voroshkov/Chorus-RF-Laptimer/docs/rx5808-spi-mod.md

#rx5805 SPI modification
In order to get the rx5808 to use SPI you will need to open it and remove a single SMD resistor.
(got this from [sheaivey/rx5808-pro-diversity](https://github.com/sheaivey/rx5808-pro-diversity) repository)
rx5805 SPI modification
