voroshkov/Chorus-RF-Laptimer/docs/pcbs.md

# PCB designs

## By Andrey Voroshkov:
PCB by Andrey Voroshkov

## By Joao Reis:
PCB by Joao Reis
