voroshkov/Chorus-RF-Laptimer/docs/img/ArduinoIDE_Menu_SerialMonitor.png

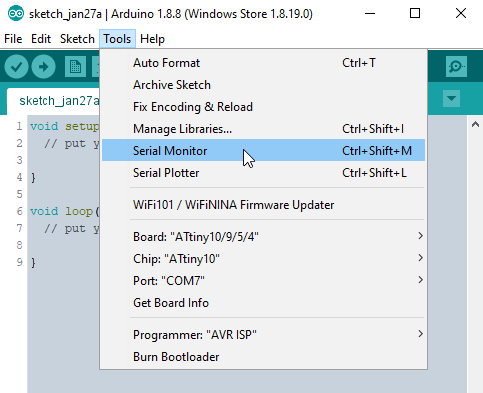
docs/img/ArduinoIDE_Menu_SerialMonitor.png
