voroshkov/Chorus-RF-Laptimer/docs/img/3DR_modules_setup.png

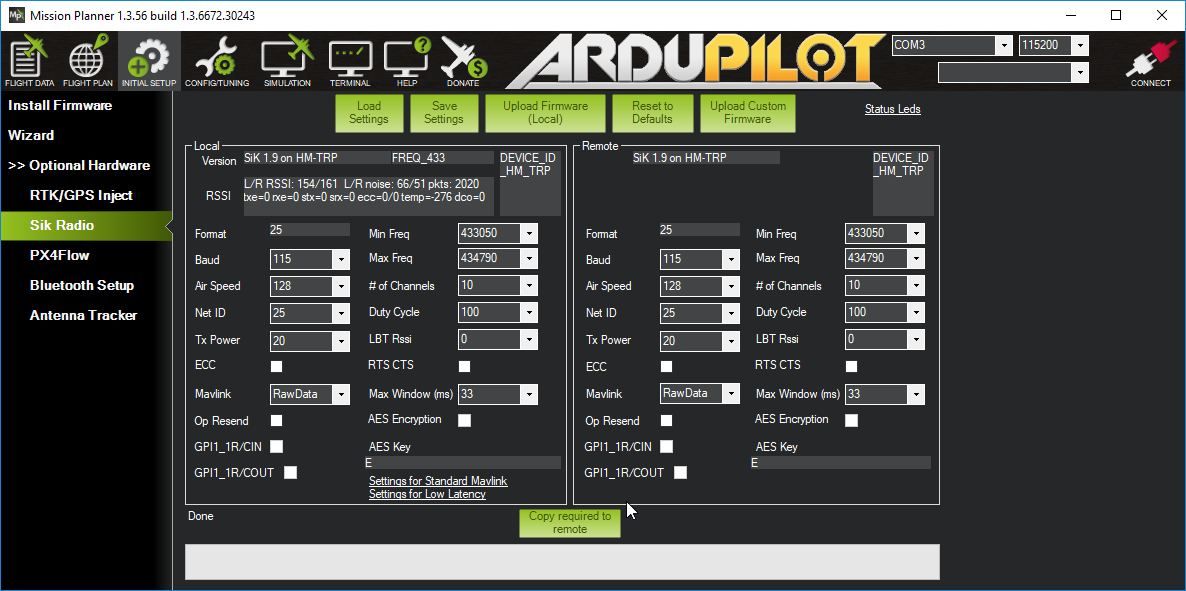
docs/img/3DR_modules_setup.png
