voroshkov/Chorus-RF-Laptimer/docs/img/HC06SetupArduinoSerial.png

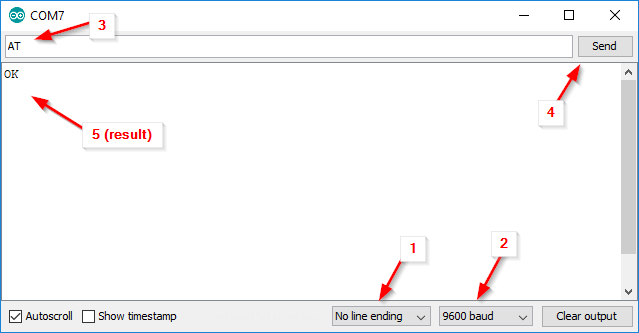
docs/img/HC06SetupArduinoSerial.png
