voroshkov/Chorus-RF-Laptimer/(threads)

Thread 3 (2017-03-14):

[Feature Request] Freq management

TJohn7002, 2017-03-14:
Hi Andrew,

I've got several ideas regarding frequencies management in Android app:

1. Display Freq, not only Channel and Band
2. Add ability to auto choose Using Freq from app\on device start-up (to make it more independent from android app):
2.1. Plug in battery in drone
2.2 Turn on Chorus device (or press it's button) (at ~1-2 m distance)
2.3 Chorus should scan all available bands and choose the one with strongest RSSI (~). Play sound when ready, go into Timer mode, play sound again
3. Save last used settings in App\or (and) Chorus device (Pilot name and Freq)

P.s. Timer mode is just like Race mode, but without limitations of lap number - just to save the timings

voroshkov, 2017-03-14:
Completely agree with 1 and 3.
What concerns 2 - it seems useful for a single racer, but looks inconvenient when you prepare a competition of several drones.

TJohn7002, 2017-03-14:
I was thought about this.
But there's workaround I've found:
1) In case if you you have single-RX device - I completely agree with you, there can be issue. Needed "Next" button as it done in  rx5808-pro Autoscan feature
2) In case if you have multi-RX device (able to measure >1 freq at the same time), then auto-scan can work step-by-step:
1) Search first strong Freq, assign it to first RX module
2) Continue search for next bands, and assign it to next modules.

But I agree -there could be collisions of bands because some chinese Tx are transmitting at several channels at the same time =(

voroshkov, 2017-03-14:
That makes sense. From UI standpoint it can be as simple as adding a button on a "Freq" tab, like "Autoscan", which will automatically scan known bands and assign different signal peaks to different devices!
So you'll just have to turn on all drones and click "Autoscan" to have bands/channels assigned.

TJohn7002, 2017-03-14:
Yep, that's I was thinking about)
Let's device itself do it's work)
Moreover I think it is possible to make Chorus device standalone:
add OLED screen and 3 buttons to make it independent from android app... This will increase cost of project by ~4$ but make it completely different from other devices that are already in the market.

voroshkov, 2017-03-14:
Well, the latter is questionable :)
Adding OLED will require separate controller for it (one more Arduino) and won'be convenient for organizing competitions, which was the primary target for Chorus.

TJohn7002, 2017-03-14:
Ok, just  ignore it than)

Thread 4 (2017-03-14):

[Feature Request] Android app > Use speech API to say last\best times

TJohn7002, 2017-03-14:
I think it will be great to hear last lap time once app got it from Chorus device.
Also it will be useful to hear best lap time right after last lap time.
smth like "Last lap: 23.6 sec... Best lap: 18.2 sec"
For the new best lap it will be just like "New Best lap: 15.8 sec"

highway11, 2017-03-14:
I agree this is a great idea. It  is a very beneficial feature to hear your lap times called out as you are flying with the goggles on!

Another open source lap timer I built does this. It runs in the web browser though, and I much prefer the Android app interface you have built for this one.

voroshkov, 2017-03-26:
https://github.com/voroshkov/Chorus-RF-Laptimer/pull/10

Closed 2017-03-26.

Thread 5 (2017-03-15):

Application doesn't seem to read BT data after reconnecting

voroshkov, 2017-03-15:
1. Power on Chorus device.
2. Connect from mobile app -> settings and current RSSI measurements are shown in the app
3. Disconnect
4. Reconnect again -> RSSI values are not being updated.
(not always reproducible)

FranzAr, 2017-03-15:
I can confirm this behaviour. If you kill the app completely and then restart it, it works again.

KingModest, 2017-03-17:
So there are actually two cases, when this bug appears:
1) launch app -> if connects -> exit with back button -> launch app -> connect -> (bug - not connecting properly)
2) launch app -> if connects -> disconnect -> connect -> (bug - not connecting properly)

The only way - is to kill the process of the app and connect

voroshkov, 2017-03-17:
Can you specify the symptoms of "not connecting properly?"

voroshkov, 2017-03-17:
As discussed: The app stops interaction with Bluetooth (doesn't transmit/receive data).
in the 1st case described by @KingModest FREQ and PILOTS tabs are empty.
in the 2nd case - UI remains, but buttons don't work (no data transmission occurs)
(Observed in Android 7.1.1)

Closed 2017-03-18.

Thread 7 (2017-03-16):

[Feature request] Low voltage Alarm

voroshkov, 2017-03-16:
It would be nice to have a low voltage alarm in the application if Chorus device is powered from accumulator.

traced, 2017-03-20:
Dont know if that would be useful, mostly it will be powered by a 5v stepdown. You would need another voltage divider "in front" to get the voltage in front of the stepdown.

voroshkov, 2017-03-20:
Right. That's not a priority, but nice to have.

Closed 2017-04-11.

Thread 8 (2017-03-17):

App doesn't update RSSI values after Chorus device was reset

voroshkov, 2017-03-17:
1. Power on Chorus device.
2. Run Android app and connect
3. Disconnect
4. turn off Chorus device, then turn back on.
5. Reconnect Android app
Result: RSSI readings not updated, whereas other features are working (swich channels, etc).

Closed 2017-03-18.

Thread 9 (2017-03-18):

Client application for different platforms.

Rikbruggink, 2017-03-18:
Hi!,

Would it be possible to create apps for different platforms like IOS or a as standard webapp for different embedded platforms like the Rasberry PI?

voroshkov, 2017-03-18:
Unfortunately I don't plan to learn iOS development in the nearest future. I'd be happy to assist if any iOS developer would join the initiative and create the app.

Rikbruggink, 2017-03-18:
Would it be possible to share the serial commands specification?

voroshkov, 2017-03-18:
It's already available in wiki: https://github.com/voroshkov/Chorus-RF-Laptimer/wiki

traced, 2017-03-20:
Just read about iPhones and the cheap HC-05 and HC-06 bluetooth modules. They don´t work with iPhones.

Rikbruggink, 2017-03-21:
Found the same info that the HC-* series are not compatibel with the Iphone, HM-10 is and around the same cost. @voroshkov thank you for the wiki link. I don't have the time currently to create an iphone app, sorry for that. Will follow the repository for updates.

nickspiel, 2017-06-14:
I am going to give a web app a crack. Just waiting on the parts to arrive. Should have something in a couple of weeks.

ps915, 2017-06-15:
awesome. looking forward to this

timofpv, 2017-10-10:
I could help with an WiFi webserver / homepage based soloution with an ESP8266. Would work with every device with an Browser and WiFi - laptop smartphone even with an ebook reader

voroshkov, 2017-10-10:
Hey, that's what I'm going to try in the nearest future. Would you contact me in facebook messenger to share/coordinate?

voroshkov, 2017-10-19:
App for iOS is in beta testing stage! You can join testing as described here: https://github.com/voroshkov/Chorus-RF-Laptimer/blob/master/README.md#hot-news-

nikybiasion, 2018-01-28:
Any news about a web app?

voroshkov, 2018-01-28:
nope. sorry. out of my priorities for now

Zai, 2019-04-21:
We are actually working on an integration of chorus to our web app : RotorMatch.com :)

voroshkov, 2019-04-22:
@Zai, let me know if you need any assistance regarding Chorus API or have any integration questions

Zai, 2019-04-22:
@voroshkov thx ! Actually I'm learning your API to see how I can wrap it to work with ours. ;)
I come back soon with a first integration to test. :)

Thread 11 (2017-03-22):

Store Channel, Pilot Name, and RSSI settings of each device between sessions

highway11, 2017-03-22:
A nice feature would be if the system could remember the last used settings for each device:

1. Channel/Band selection
2. Pilot name
3. RSSI Threshold. (this one may be debatable, as this might be better to set every time?)

Also (but less important) store these preferences: Enable Sounds, Enable Speech, Laps To Go, Min Lap Time

For example, at our weekly meetups, we always use the same 5 channels, (IMD5) and often even the same Pilots so it would be nice to be able to turn on the Chorus and the app automatically sets them all to the last used settings. This would make setup time very fast.

traced, 2017-03-22:
I think these values could be easily stored into the eprom?!

Closed 2017-04-11.

Thread 12 (2017-03-23):

RSSI not shown on last device

FranzAr, 2017-03-23:
Have 4 devices, on the Pilots tab the last device RSSI shows "1". If I do "Set" it works correctly. Laps are also triggered correctly.

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

voroshkov, 2017-03-23:
Did you update the Android app and Arduino firmware since last weekend?
Is the issue persistent? Does it work this way right after connection and after disconnect/connect cycle?

FranzAr, 2017-03-23:
Yes, both latest version

voroshkov, 2017-03-23:
Do you have the problem with 4 devices only? Can you describe the use case?

FranzAr, 2017-03-23:
Yes, had no problems like that with only 2 devices. Was just testing on the bench, but I could reproduce this behaviour every time. Gonna do some more investigation, when I have the time. On the Freq Tab it shows the right value, it's only on the Pilots tab. Just a small issue but wanted to let you know.

voroshkov, 2017-03-23:
Got it. Thanks. Will take a look.

voroshkov, 2017-03-24:
I guess I've found the reason of the described issue.
@FranzAr, can you try the updated APK from attached archive and let me know if it fixes the problem?

[ChorusRFLaptimer-release.zip](https://github.com/voroshkov/Chorus-RF-Laptimer/files/867188/ChorusRFLaptimer-release.zip)

FranzAr, 2017-03-24:
Great, I'll try it tonight

FranzAr, 2017-03-24:
Yes, problem seems to be solved, I get plausible values now on all 4 devices.

voroshkov, 2017-03-24:
Cool. Will include the fix into next release then.

Closed 2017-03-25.

Thread 17 (2017-04-13):

Idea: Alternative connection through FTDI/UART

Szpero, 2017-04-13:
Reason: BT and 2.4GHz are often jammed by frsky and other stuff. 433MHz for example will handle without a problem with much more longer distances.

Idea: Connect FTDI converter through OTG cable.
To FTDI you can connect any device like:
- straight cable to arduino
- 433MHz (or other) modems on frequencies which are not in use by race quads.

Application: need to be changed.

Arduino side: no need - just any other device than BT module.

Hardware: For example FTDI based on CH340G (tested with library) and pair of transmiting devices which can handle 115kbps on air.

Proposed library: https://github.com/mik3y/usb-serial-for-android

I'm not so expeirenced with java but for now only FTDI library is merged.

traced, 2017-04-13:
Can 433Mhz modules handle the baud rate?

Szpero, 2017-04-14:
Many 433MHz data links for pixhawk/apm telemetry are able to use 250kbps air speed to maintain 115kbps inner connection for device.
Here is example of device which is working at different frequency but its able to work at 250kbps also:
http://www.banggood.com/3DR-Radio-Telemetry-915MHZ-Module-For-APM-APM2-p-73539.html

From what I've seent most of those devices are using:
- USB with build in FTDI converter
- transmiting modules which can be configured with AT commands.

Within end of month I'm going to replace BT module (config link) on my Pixhawk flyer. It is good oportunity to check link device for other purposes :)

tigert, 2017-04-15:
Would it work with a ESP2866? Those are arduino compatible, so you could run the whole thing in one, and setup a wifi hotspot on your phone.

You could even log the results in a mqtt server or talk to the app over wifi.

traced, 2017-04-15:
ESP8266 works with 3.3v, so you would need something to provide two voltages (3,3v for ESP and i think 5v for the RX module).

tigert, 2017-04-15:
If you have one of those modules with usb, like the nodemcu amica or adafruit huzzah, there is the usb/5V pin if you power it via usb. I do that to power a DHT11 temperature sensor that also needs 5V and it works.

tigert, 2017-04-15:
Or maybe some logic level converter might work.

Closed 2017-07-01.

Thread 19 (2017-05-01):

Android apk build

mclei, 2017-05-01:
I am not Android developer, so maybe stupid question, but I am not able to compile the application with this error:

FAILURE: Build failed with an exception.

* What went wrong:
A problem occurred configuring project ':app'.
> Could not resolve all dependencies for configuration ':app:_debugApk'.
   > Project :app declares a dependency from configuration 'compile' to configuration 'default' which is not declared in the descriptor for project :bluetoothspp.

Please could you help me?

voroshkov, 2017-05-01:
I use latest Android Studio for compiling. It should work without issues.

mclei, 2017-05-01:
I am also using latest Android Studio on Debian/Squeeze. Both Studio and "gradlew assemble" throws this error.

voroshkov, 2017-05-02:
Well, to be honest, I'm not an Android developer either. Hope somebody more experienced could help here.

gpolic, 2017-05-02:
That is a long shot, but are you sure you are using "Import Project."?
Usually when trying to open a project directly there are various problems. Import project, is taking care of the dependencies.

Also try to update Gradle and see if it makes a difference.

I am on windows and the latest Android Studio and I cannot recreate this error message.

mclei, 2017-05-02:
I am also not Android developer. I am using "Import Project". Have gradle 3.5 and Android Studio 2.3.1.
Why I want to compile the project is that there is explicitly forced English for Text to Speech and I want to use the system settings.

gpolic, 2017-05-03:
I am not Android Developer either, but I am trying to learn.

Looks like the Text to Speech code is hard coded for U.S. settings
I dont know how to change that but will have a look

voroshkov, 2017-05-03:
Yes, it's all hardcoded so far. In order to Internationalize we'll need to make localization for the entire app. (all texts, user-defined spoken messages, etc.)

voroshkov, 2017-05-03:
Btw, the code becomes more and more ugly with adding new features (due to flaws in initial design and lack of Android development experience). Need to perform thorough refactoring before implementing anything significant.

mclei-asw, 2017-05-03:
But your project is COOL and we are already using it in the field :-) Thanks.

mclei, 2017-05-03:
But your project is COOL and we are already using it in the field :-) Thanks.

gpolic, 2017-05-04:
Inside TextSpeaker.java in the onInit method
You can use this to obtain the default locale, and pass it to setLanguage instead of "Locale.US"

@TargetApi(Build.VERSION_CODES.N)
public Locale getCurrentLocale(){
    if (Build.VERSION.SDK_INT >= Build.VERSION_CODES.N){
        return getResources().getConfiguration().getLocales().get(0);
    } else{
        //noinspection deprecation
        return getResources().getConfiguration().locale;
    }
}

I found this info here:
http://stackoverflow.com/questions/14389349/android-get-current-locale-not-default

Also this is very useful:
http://stackoverflow.com/questions/38189386/texttospeech-setlanguage-not-working

mclei, 2017-05-04:
Yes, I have ideas how to change it, but I am not able to compile the project and this task is about it :-)

gpolic, 2017-05-04:
I would do the change in a PR, but I am unable to test :-(
maybe @voroshkov can compile that for you and include it in the project

As for the refactoring. Yes it maybe needed specially if new functionality is being added. You could start by doing adding more test units, to assist in more efficient refactoring.

voroshkov, 2017-05-04:
As for including this into the project:
Guys, I don't think using system locale is enough for the app to work properly. All messages should also be localized and auto-selected upon choosing a locale.
Also this may result in not speaking pilot names (if they don't correspond to system locale): e.g. I tried using my name in Russian, but Speech Engine with US locale just doesn't pronounce it.

gpolic, 2017-05-04:
oops! yeap you're right. Translation is needed.

lnx13, 2017-06-19:
`Project :app declares a dependency from configuration 'compile' to configuration 'default' which is not declared in the descriptor for project :bluetoothspp.`
This error occured becose you use case sensitive file system, just rename bluetoothSPP to bluetoothspp

mclei, 2017-06-19:
Confirmed, never noticed it is that simple :-)

Closed 2017-06-19.

Thread 20 (2017-05-06):

Help with Arduino Nano

androidiano78, 2017-05-06:
Hi,
I just finished assembling a Solo device, but with Arduino Nano (not having Arduino Pro Mini). For now I have missed the part for voltage Lipo monitoring. That said, everything connects to the application via the bluetooth module, but I did not understand, the FREQ android app page, what is that number next to Device # 1, in my case 234. Going to the PILOTS page, RSSI Threshold gives me Always 1, and until I insert the above mentioned number (234), but it does not give me the option to set it, START RACE (1PILOT) does not appear on the RACE page. Once START RACE starts and I try to make a ride with the quadcopter (walking naturally for now, both with powered and non armed motors, but I do not think it makes any difference) when I step in front of the device nothing happens and does not ring buzzer. I would need help to figure out what the problem is, especially with wiring, since I am using Arduino Nano, but it should be compatible. I have only one device, so I did not connect the 4 pins to series more devices; In addition I did not even have the bridge to shorten two pins of Bluetooth (loopback jumper in scheme), I seemed to understand that it was to do for multiple connected devices.

My PinOut and configuration:

I supply everything from lipo - bec USB to mini USB - Arduino nano;
Ch1-Ch2-Ch3 (RX5808) - 1k resistors - D12-D11-D10 (Arduino nano);
GND (RX5808) - GND (HC-06 Module) - one of the 2 GNDs (Arduino nano);
+ 5v (RX5808) - 5V (Arduino nano) - VCC (HC-06 Module);
RSSI (RX5808) - A6 (Arduino nano);
Positive (Buzzer) - D6 (Arduino nano);
GND (Buzzer) - one of the 2 GNDs (Arduino nano);
RX0 (Arduino nano) - TXD (HC-06 Module);
TX1 (Arduino nano) - RXD (HC-06 Module).

I attach some photos and thank you in advance.
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

voroshkov, 2017-05-06:
Why do you connect RSSI to A6?

androidiano78, 2017-05-07:
Oh my god, I apologize for the lapse and for the time that I made you lose .... I put the pinout, which among other things I was wrong also the CH, and now magically everything works. Now I have to test it only in flight. Congratulations on the work done

voroshkov, 2017-05-07:
Good to have it solved! :)

Closed 2017-05-07.

Thread 22 (2017-05-27):

Built with 5 SOLO issue

vannoz, 2017-05-27:
Hello, I built a Chorus version with 5 SOLO. I have an issue when selecting players: name of 5th and 1st are the same and 5th SET rssi value doesn't change from 0, rtx receive the signal, but button SET doesn t work..only strange bip...any idea?
(Wirimg is ok, Uno pro are all ok...)
thanks

voroshkov, 2017-05-30:
Can you make sure you use the latest app? Does it have LiPo monitor adjustment feature?
If yes, then please specify what Android device you are using.

voroshkov, 2017-05-31:
Is Freq tab entirely visible on the screen or the 5th item is off?

vannoz, 2017-06-01:
Hello Andrey, here you can see a video from my mobile:
https://youtu.be/iBP88XJ0LvI
Thanks
Ciao
Andrea

Il 31/mag/2017 16:29, "Andrey Voroshkov" <notifications@github.com> ha
scritto:

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

voroshkov, 2017-06-01:
Thanks for the vid. I'll try to investigate what's happening. Looks like incorrect handling of  lists in android app. I'd appreciate if experienced Android devs could join and help here.

vannoz, 2017-06-01:
Yes...unfortunately i'm olny Android user :)
maybe depends on the software you have used to build the Android app...I
tried the MIT App Inventor...but is not easy

Il 01/giu/2017 10:53, "Andrey Voroshkov" <notifications@github.com> ha
scritto:

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

maddust, 2017-06-21:
I'm having the same problem . Any update with this issue?

vannoz, 2017-06-21:
I think nothing up to now...Andrey is working to solve

Il 21/giu/2017 21:31, "maddust" <notifications@github.com> ha scritto:

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

voroshkov, 2017-06-22:
Does anybody experience the same issue having different number of nodes? 4, or 6?

vannoz, 2017-06-22:
With 4 units no problems...i don't have a 6th unit to do the test sorry

Il 22/giu/2017 08:40, "Andrey Voroshkov" <notifications@github.com> ha
scritto:

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

vannoz, 2017-07-04:
ciao Andrey, I have some suggestios.
I tested this Sunday the laptimer chorus RF...mine is 5 unit...but if you
remember only 5 are working on the android app...
I used with 4 racers per time...we selected only 4 VTX frequencies...and
all the time I was changing the pilot name...then loosing a lot of time
My request is> is it possible to add a page where to list all players name,
then when preparing the partecipants to a race, select the names of the
participants from a drop down menu?
it will be also a good things to assign a COLOR code to some frequency...
it will be also a good things to see the MHz freq value per each
channel/band...because some time the VTX on the quad has not the same table
MHz vs channel/band...

thanks
ciao
Andrea

voroshkov, 2017-07-04:
@vannoz valid points, but out of scope of this bug. Would you create a feature request(s) instead?

highway11, 2017-07-04:
I'm also experiencing this bug. I recently added 2 more modules to upgrade from a 4 unit to 6 unit device. In the Pilots tab any changes I make to the 6th module get mirrored to the first one. I also cannot disable the 6th module to continue with 5 as the checkbox does not seem to work on the 6th as well

vannoz, 2017-07-04:
Thanks. So I just have to install the new version?

Il 04/lug/2017 22:17, "Andrey Voroshkov" <notifications@github.com> ha
scritto:

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

vannoz, 2017-12-14:
have you seen this?
https://www.banggood.com/LANTIAN-5_8G-Wide-Voltage-Bluetooth-Timer-Personal-Practice-Version-for-FPV-Racing-Drone-p-1237993.html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

voroshkov, 2017-12-14:
Yep. Already discussed in FB group :)

vannoz, 2017-12-14:
Ah ok...sorry :)

Il 14/dic/2017 12:46, "Andrey Voroshkov" <notifications@github.com> ha
scritto:

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

voroshkov, 2017-12-14:
Oh, you really shouldn't be! Thanks for notifying anyway!

vannoz, 2017-12-14:
You did a great job...so I was scared seen others gain money with your idea!

Il 14/dic/2017 12:50, "Andrey Voroshkov" <notifications@github.com> ha
scritto:

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

voroshkov, 2017-12-14:
If I could make huge money of it I'd try to :) So far I'm happy as it gains popularity as long as the license permits :)

Closed 2017-07-04.

Thread 23 (2017-05-31):

Only one Pro Mini

mario123456789o, 2017-05-31:
Hi,
wouldn't it be possible to use one Arduino only. Wire all the spi pins as in the rx5808 diversity, but use different pins for the chip Select pins. So if you have for rx5808, wire chipselect 1 to d1, cs 2 to d2 ...
So you would use only one arduino, the stackability is a bit worse, because you have to limit it to number of rx5808, but to be honest who needs more than 8 different modules?
If my rx5808s ever arrive, I will test this.
Greetings
Mario

voroshkov, 2017-06-01:
Theoretically it's possible, but out of scope of this project, sorry.

mario123456789o, 2017-06-01:
Ok
I'll try my idea as soon as my rx5808s arrive, and if it works I'll notify you :).
The limitation is that we only have 8 analog pins available(at least for my arduino :D) so a maximum of 7 rx5808s can be used. But this should be enough for most people otherwise you have to sacrify the battery pin.
The other problem might be the performance, that the arduino is too slow to read 7 analog inputs in realtime

Closed 2017-07-01.

Thread 25 (2017-06-06):

Bluethooth Range

ps915, 2017-06-06:
Hey Guys,

Whats your Bluethooth Range? HC05 has a pretty bad range so here is an idea.

To keep the Tracker Compact, we might use a class 1 bluethooth module. That will get us 100+ meters range: https://www.sparkfun.com/products/12580

The bad thing is, that most smartphones dont support class 1 except the iPhone 7 i think.

So, maybe its possible to write an Chrome App, or standalone App for a Laptop and use this Class 1 Bluethooth Adapter.

https://www.sparkfun.com/products/9434

A friend also tested various wifi modules like ESP... he only got 10 meters and had TCP/IP packages losts

...or..

is there any "Android App" Emulator which accepts bluethooth connectivity?

ps915, 2017-06-06:
I have an other idea for increasing the range dramatically without loosing the bluethooth feature.
Lets build a master slave class 1 bluethooth gateway. Should work:
https://cdn.sparkfun.com/datasheets/Wireless/Bluetooth/bluetooth_cr_UG-v1.0r.pdf

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

highway11, 2017-06-06:
I find it makes a big difference if you can elevate the bluetooth module above the ground. I use CAT5 cable to extend mine out and away from the Chorus box.  I can get around 50m away from it and still have communication that way. Its elevated maybe 1.5 meters off the ground.

ps915, 2017-06-06:
Thanks for your contribution. 50m with Cat5 is awesome. i should try that. If it works stable, the above solution is overkill, indeed! =)

highway11, 2017-06-06:
My CAT5 cable is only about 4 meters long. Then I just mount it on a stick to elevate it :) Very low tech solution, but it works for me!

ps915, 2017-06-25:
I just bought this as a range enxtender =)

Chorus -> UART RF  .>.>.><.<.<. UART RF -> HC05/Laptop (Gui from Daniel Müller )

https://www.aliexpress.com/item/2x-UART-RF-Wireless-Transceiver-Module-USB-to-TTL-RS232-Telemetry-Kit-2-4G-for-Arduino/32239562366.html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

FranzAr, 2017-06-25:
Phil, does ist work like expected?

ps915, 2017-06-25:
I'll report back asap I'll hold it in my hands. ;)

FranzAr, 2017-06-25:
Ah, thought you got it already. I'll be waiting ;-)

rcdesigns, 2017-07-15:
I hang my timer from a tree branch and easily reach 20m to where we sit. I'm sure it would go further.

rcdesigns, 2017-07-15:
I presume soldering on a better antenna would improve things a lot

Thread 28 (2017-06-25):

8in1 PCB Version 2

ps915, 2017-06-25:
OK guys,

a while ago, i created a 8in1 PCB for the Chorus Tracker. It was my first design and of course the PCB was not 100% correct. There were some GND Pins of the Arduino not connected together "GND Island Fail".

Now i came up with the Idea to create a stackable design.

So there will be a 10x10 PCB with all the RX5808 receiver on top. You can either direct solder them or stackable with Pin Headers.

A second PCB, the Main PCB will be connected also with pin headers.

I will create a second Main PCB for the Delta 5 Tracker as well. So one can choose if he wants to build delta5 or chorus.... or even another tracker.

All Arduinos from the PCB before can be used for this PCB as well. 2 pin headers were added becaus i included a buzzer which is shared with all 8 nodes via some schottky diodes.

There is also an option to mount two XT30 connectors to the PCB and also a stepdown (Pololu 5V, 2.5A Step-Down D24V25F5) to power the whole unit via a LiPo. Second option is to power the unit via a external 5V source (powerbank)

Why two XT30? If the battery will run out of power, just connect a fresh one and charge the old one.

An other feature is the Rj45 jack where you can plug in a network cable to extend the range of your bluethooth.

What is your opinion? Whats missing?

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

Rikbruggink, 2017-06-26:
It looks really great Phillip!. Are you gonna release the pcb's to seedstudio or osh?

ps915, 2017-06-26:
sure, they will be released on Seeedstudio when the testing is done and everything is fine

ps915, 2017-07-10:
Update: Just decided to go with 8in1 PCB, no stackable RX PCB :-P

Ok guys. I spend a few weeks designing Chorus 8in1 V2 which should be the final version.
Features:
- 10x10 PCB
- up 8 Nodes (if you use 6 nodes, just bridge TX/RX)
- 1 shared buzzer for all nodes (protected by diodes)
- 2x XT60 Input
- 2x MicroUSB 6V Input (Adafruit MicroUSB Breakout Board)
- 1x Serial Output RJ45 Socket
- 2x Serial Output Pin-Header
- 5V Stepdown ready (MP1584EN)
- all parts stackable (parts can be replaced easily, also better airflow, less heat)

As always, i will test it before publishing, but i think i wont find any issues this time =)
After that, you can order it yourself on seeedstudio.com
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

cbnlnk121, 2017-09-04:
@ps915 Maybe I'm missing it, but what's up with the dual XT60? I assume is runs right to the 5V stepdown first? Sorry for the newb question, just having a hard seeing the trace.

cbnlnk121, 2017-09-05:
Deleted my prior comment ... Re-reviewing the trace, it's dual inputs. Great idea! Thanks!

Chewpasta, 2017-12-03:
hi, i have a cuestion in this project, do you have a pcb with only 4 nodes?  ty!

ps915, 2018-02-16:
I wont release the 8in1. Instead i nearly finished the 4in1. Stay tuned!

Closed 2018-02-16.

Thread 29 (2017-06-26):

Feature Request: WS2812 LEDs

ps915, 2017-06-26:
Why not hooking up a WS2812 LED Stripe to the first node?

1. Pilot Colors
Every Pilot gets a color and the start gate will shine in the pilots color when passing it.

2. Visual Countdown
add a bright ws2812 led panel in front of the starting pads or even the whole start gate.
So there is a visual start sign. When the race is finished or the pilot has max laps, the gate will show red.

What do you think?

Code: https://github.com/adafruit/Adafruit_NeoPixel

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

FrufoFPV, 2017-06-26:
I really like the idea. Its pretty much the same as TBS has implemented for their Racetracker and SmartGates.

Ziege-One, 2017-06-26:
Nice
 I would build it as a new module like the others.
All information comes over the serial line.
So you pick them up

AABatteries, 2017-06-28:
I would recommend using the FastLED library as opposed to NeoPixel one - it's more versatile, and offers better performance than the latter.

It would be a great addition, I might make a pull request once I have it working (but no earlier than a month time). I think adding a connector (just 3 pins) to make it possible to plug in a cable to both power (from the same LiPo) and send signal to the LEDs, so that the tracker can be placed away from the gate, would be the easiest/best way to physically implement this.

Repo for FastLED can be found here: [FastLED library on GitHub](https://github.com/FastLED/FastLED)

reptil1990, 2017-07-10:
I started coding! Could need some help: https://github.com/reptil1990/Chorus-RF-Laptimer

voroshkov, 2017-07-12:
Idea for possible implementation of this feature: instead of loading the Solo module with new features you may like to create a separate Arduino module which will just proxy all commands as other modules do, but implement only its specific functionality (drive LEDs in our case). So the chain of modules might look like:
Solo <-> Solo <-> ... Solo <-> LED module <-> Bluetooth.
This way the LED module will "see" all commands/responses from other modules and may be also programmed using a separate command set.

voroshkov, 2017-10-09:
Implemented in Chorus-LED-Module project.
https://github.com/voroshkov/Chorus-LED-Module

Closed 2017-10-09.

Thread 40 (2017-07-09):

[request] - Manual RSSI input

jRreis, 2017-07-09:
Request for manual RSSI input in Text format in android APP.

RSSI can only be Set/Clear and Increased or decreased by the value of 1, every time +/- is pressed.

It would be a plus to allow RSSI values to be directly inserted, as text format, for manually set the value.
E.g.. if we want to set manually an RSSI of 243, "+" must be pressed until that values is reached.  In text, we would be able to directly input the value "243".

FranzAr, 2017-07-09:
+1
Great idea, maybe RSSI value could be stored, as you don't really have to change it a lot for different quads.

rcdesigns, 2017-07-15:
Yes, just storing the last RSSI value would be great.  I find I'm always using around 200 and don't need to calibrate every time.

kestux75, 2017-08-22:
+1 for storing the last RSSI

voroshkov, 2018-04-27:
done in release 0.6.1: https://github.com/voroshkov/Chorus-RF-Laptimer/tree/0.6.1

Closed 2018-04-27.

Thread 43 (2017-07-12):

Feature request : allow communication with LapTimer modules using OTG USB device (3DR telemetry receiver, FTDI, ...)

sky022, 2017-07-12:
Hi,

This is the first issue I write on GitHub... :)
I made several laptimer modules since a few days, and it works like a charm. I'm using Bluetooth to UART modules as recommended, but the range is not so great.

I was thinking : in fact, the whole thing is based on serial communication. To extend the range of operation, we could use something else instead of Bluetooth, that would be connected as an OTG USB device on the smartphone.

For instance, I was thinking about using a 3DR radio telemetry combo like this one : https://www.banggood.com/3DR-Radio-Telemetry-433MHZ-Module-For-APM-APM2-Europe-p-85233.html?rmmds=search

Unfortunately, for the moment the LapTimer app only connects to Bluetooth devices. Do you think you could implement something to improve the application, so that any other supported serial communication device connected via OTG USB can be used ? I'm thinking about EZ-GUI app also, which supports this kind of thing.

Thank you for reading :)

BR,
Fabien (sky022)

allsiolek, 2018-05-05:
I'm using 3dr telemetry radio right now and i just found this post. It's working, you have to setup radio properly. I'm recomending to use mavlink protocol, low netID, air speed > 128.
First radio is connected to last node, second to bluetooth / wifi module. Sometimes i have to connect two times (connect -> disconnect-> concect) with Chorus to proper readings.

voroshkov, 2018-05-07:
@allsiolek, Thanks for the info!
What's the longest range you were able to achieve with 3dr?
How do you connect it to wifi/bt module? As I can see, one of the modules comes with the USB converter to connect to PC directly. (https://www.banggood.com/3DR-Radio-Telemetry-433MHZ-Module-For-APM-APM2-Europe-p-85233.html)

allsiolek, 2018-05-12:
I didn't try further than 100m thru the buildings with stock antenna. I used this two telemetry radio:
https://www.banggood.com/500mW-3DR-Radio-Telemetry-AirGround-Module-433MHz-915-MHz-For-MWC-APM-PIXHAWK-Pirate-p-982005.html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

https://www.banggood.com/3DR-500mW-915MHz433MHz-Radio-Telemetry-Module-w-OTG-for-Android-Phone-p-1140481.html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

With first one i have stable connection. Second thing is that radio from second link hae a bug. For correct work you have to cut trace (https://diydrones.com/forum/topics/3dr-telemetry-always-bootloader).

First telmetry radio is connected to Chorus Laptimer thru RS232 TTL, second one is connected also thru Rs232 to  wifi DT06 module. I also tried with bluetooth module (HC-06) but bluetooth+telemetry radio works worse.

I did try use HC-12 433MHz modem but it didn't work. I think beacuse this modem dosen't suport full duplex transmision.

If you will able to add usb connection option it will be simple but now is still fine.
I will test for you range of stable link in open air.

voroshkov, 2018-05-14:
@allsiolek  Thanks a lot for the detailed description!

Thread 54 (2017-09-12):

I can't connect with Windows GUI

MoonKIE666, 2017-09-12:
Hello everyone,

I can not connect to the Windows application.

I connect my CHORUS 5 in 1 through a FTDI to my pc, I open the windows GUI and I get the startup window, but I only get the baud rate dropdown, I put it in 11520 and the COM port dropdown does not appear .

What's going on? My FTDI works correctly, I installed the firmware on all my mini arduino with it. And in the Windows Device Manager I appears as connected on the COM3 port.

Let's see if someone can help me.

I've also tried connecting it to GOOGLE CHROME's EASYRACELAPTIMER app, but it will not let me.

anunique, 2017-09-22:
you might want to post problems like that @ https://github.com/anunique/ChorusGUI

guess this one can be marked as solved since its not a problem with the chorus-rf-laptimer project at all ;]

Closed 2017-09-25.

Thread 56 (2017-10-01):

Different Modes for the Android app

ty8447, 2017-10-01:
Hello, I have been using the Android app a lot and love it, but I was wondering if there was a modded version of the app that includes a point mode where there is a countdown timer and during that set time, people race to get the most amount of laps. When the time is over people can finish their lap and then they are done. This is similar to how normal multigp races are scored.

highway11, 2017-10-02:
I've added this feature to my branch. It's fairly crudely implemented but you can do a timed race for 1.5, 2, or 2.5 minutes. It announces time remaining at certain intervals as well as when the time is up

ty8447, 2017-10-04:
@highway11 How would I set that up? Would I have to upload new code to the pro mini and/or download a modded version of the Android app?

highway11, 2017-10-04:
You would just need the app. There is no code I have changed for the Arduinos

Closed 2017-10-06.

Thread 59 (2017-10-05):

Cannot get the RF rx5808 module to work

ty8447, 2017-10-05:
I recently ordered 4 rx5808 modules from Banggood and when they finally arrived and I removed the metal casing, the resistor that you explain how to remove is not installed from the beginning. I solder the wires following the diagram and cannot get the app to let me calibrate/change the frequency or pilot. What does the "Lipo Voltage" go into (Red lead on the diagram), and how might I go about fixing this issue?

voroshkov, 2017-10-05:
1. Please follow the guide in the Troubleshooting section to resolve the app issue.
2. The LiPo Voltage wire should go to + of the lipo you're using to power the Chorus

ty8447, 2017-10-05:
Thank You @voroshkov, My Bluetooth baud rate wasn't set.

Closed 2017-10-05.

Thread 60 (2017-10-05):

Cannot Calibrate Timers in Chorus App

ty8447, 2017-10-05:
Now that the lap timer will connect, I have all of the functionality except in the race tab, the calibrate timers button does not show when the app connects with the device. Also, where is the button to set the current threshold?

ty8447, 2017-10-05:
I did a check with the components and found out that one of my pro mini boards was dead :( but everything now works.

Closed 2017-10-05.

Thread 61 (2017-10-06):

RSSI values drop to zero when race starts

ty8447, 2017-10-06:
I do not if this is meant to happen, but when the race starts the values go to zero. Are there any more descriptive details on how to setup the RSSI values to racing?

voroshkov, 2017-10-06:
That's ok. When you start the race, the device stops transmitting current RSSI data.
This is to minimize the BT communication with the device and keep it more reliable & accurate.

Closed 2017-10-06.

Thread 62 (2017-10-06):

Ability to Manually Type RSSI Threshold

ty8447, 2017-10-06:
Can there be an added feature in the near future to click on the RSSI value and type in a number, rather than only being able to press the buttons?

anunique, 2017-10-07:
check https://github.com/voroshkov/Chorus-RF-Laptimer/issues/40

the arduino code supports setting the rssi threshold, somebody just needs to add it to the android app ;]

voroshkov, 2017-10-07:
sorry guys, I won't add.
long button clicks changes by 30.
10 long clicks is enough to cover all range

Closed 2017-10-08.

Thread 63 (2017-10-07):

First Pilot/Device only reads 1018 for the RSSI level no matter what

ty8447, 2017-10-07:
I have two lap timers and when they connect with the phone, the lap timer with the Stepdown (Timer 1/ Pilot 1) does not give an accurate RSSI level. The second lap timer on the other hand, does work in the app and pc version. All of the wiring is the exact same on both devices and in the diagram, and I have tried everything in the troubleshooting section.

voroshkov, 2017-10-07:
please describe the sympthoms

ty8447, 2017-10-08:
When I open the app and have two Solo's connected, the second solo will give an accurate reading of the rssi value and the first solo that has the 5v step down displays 1018 for it's value regardless of Band/Channel. When you start the race, as you mentioned in another issue that they will go to zero to help with communication and that happens for both (so the software is controlling that).

voroshkov, 2017-10-08:
Maybe you have bad (or not patched) vrx.
Try measuring actual voltage on its RSSI pin - it should be around 0.5 - 1.5 V

ty8447, 2017-10-10:
If I use a multimeter to measure the rssi pin on the rx5808 using the positive lead for the rssi and ground being anywhere else (preferably the 5v step down) I get a reading of about 5v.

voroshkov, 2017-10-10:
that's wrong RSSI. probably your RX5808 is damaged

Closed 2017-10-23.

Thread 64 (2017-10-09):

Trigger on peak RSSI

kestux75, 2017-10-09:
Trigger lap time on peak RSSI. With only rssi > rssiThreshold, precision is very sensitive to vtx/antenna power and  rssiThreshold value.

voroshkov, 2017-10-09:
Please clarify. Is there an issue? Or it's a suggestion? What's the idea?

kestux75, 2017-10-09:
It's not a big issue,  but I think it would be a an improvement. Sometimes then two or more quadcopters passes finish line at the same time, I have not correct order registered. I think it's because now lap time is triggered as soon as rssi > rssiThreshold. But it's not exactly the closest point to the gate and its very sensitive to rssiThreshold setting. The closest point would be when rssi is at the max value.
My suggestion is after rssi > rssiThreshold to wait for rssi peak to register lap time.

Sorry for my english.

voroshkov, 2017-10-10:
Got it. The idea is really nice. Need to think and experiment.

elvince, 2017-10-13:
In fact, you can take some inspiration from https://github.com/scottgchin/delta5_race_timer
His program is better suit to get the best lap time because it sample different value one the threshold is reached and wait until the rssi value is lower. Then it "save the highestepeak time as the lap time. This will greatly improve your code.

BTW, thanks a lot for sharing to the community, this is a great stuff.

voroshkov, 2017-10-13:
Thanks for pointing out. I'll take a look.
At the same time I heard rumors that Chorus worked better than Delta5 in certain conditions ;)

elvince, 2017-10-13:
Might be, it would be great to know what were those conditions.
The simple implementation is to read multiple value between Threshold  reached / unreached and keep the highest rssi peak for the laptime.
Then we can see if there are "false positive" during this period and check delta value after/before the peak and use that to compare to the 2nd "best value". If gap are big, the 2nd value might be the best one. What's important to improve the system is to know in real testing, if we have wave rssi peak. I mean, you start getting bigger value, then drop a bit then up again then drop.. up ... and got under the threshold. If this is the case, the simple implementation won't work and we need to create a more robust approach.
 I have no clue how it will react in reality, it is just coding approach.
I need to create my timer first ^^

voroshkov, 2017-10-13:
True. It would be great if someone had enough courage and time to make the research and suggest a good algorithm :)
On the other hand I strongly believe that the "right" construction of the laptimer box might also be the clue to more sharp readings. E.g. narrowing down the "RF sensitivity window" (whatever it might be) will eliminate the necessity of improving the software.

anunique, 2017-10-14:
well this could be possible if the first gate pass == tracker pass.
i woulnt use the way delta5 uses since they so somethink like:
((time of rssi trigger value edge up)+(time of rssi trigger value edge down)) / 2
if the tracker is placed directly infront of the first gate you could simply increase the value till its falling down a special rssi value ?

fape, 2017-10-26:
By me you can get some inspiration from [Chickadee laptimer58](https://www.rcgroups.com/forums/showthread.php?2558061-Chickadee-Tech-DIY-Laptimer) too.

Thread 65 (2017-10-12):

Possibility to change VOLTAGE_DIVIDER_CONSTANT in app instead of hardcoded

Maarten112, 2017-10-12:
Hi Voroshkov,

Let me start by saying: THANK YOU SO MUCH for this great project and making it opensource.

I noticed that in the hardware schematics you use a voltage divider with 10K and 1K, however, I found this a bad choice for a 3S lipo that I will use since the resolution is really low with this kind of voltage divider and the use of a 3S Lipo:

Full 3S lipo: 12.6V --> 1.145V out of the voltage divider
Empty 3S lipo: 9.9V --> 0.9V out of the voltage divider

The resolution with this divider is 0.245 volt (+/- 50 digital resolution)

I choose to use a voltage divider with 10K and 22K, since it gives much better resolution:

Full 3S lipo: 12.6V --> 3.938V out of the voltage divider
Empty 3S lipo: 9.9V --> 3.094V out of the voltage divider

The resolution with this divider is 0.844V (+/- 172 digital resolution)

In the app (AppState.java) on line 43 you hardcoded the voltage divider constant that is used for the final battery voltage calculation:

public static final double VOLTAGE_DIVIDER_CONSTANT = 11; //(10K + 1K)/1K

It would be great to not hard code this, but make it editable in a configuration menu (or maybe advanced configuration menu?).

voroshkov, 2017-10-16:
Is your choice of resistors suitable for lipos from 2s to 6s?
On one hand the feature of Lipo monitoring is supplementary, and doesn't require high resolution.
On the other hand, using higher resistances leak less current and provide better monitoring capabilities.

On one hand I'd avoid changes to schematic as many people already developed their devices.
On the other hand it might be solved by allowing to configure it via UI, as you suggest.
At the same time I'd really avoid adding too much configuration options to UI.

Kind of difficult decision :)

Maarten112, 2017-10-16:
Hi voroshkov,

No this voltage divider is only suitable for up to 3S (and gives the best resolution on 3S). A full 4S lipo would already give 5.25V out on the analog pin and probably destroy the arduino.

I agree with you that the android app should be as clean and simple as possible, there is no point in making it over complicated. I understand your concerns, however I think there is no real good argument to use a 6S lipo for the Chorus laptimer hardware, since we only need a maximum of 5V (or perhaps 12V for an external fan). It would only put more stress on the dc dc regulators to use 6S.

voroshkov, 2017-10-17:
@Maarten112, the device is quite energy-hungry, especially taking into account possible number of nodes, so this is the main reason to power it with batteries of high voltage and capacitance. I find it absolutely reasonable to power it with 6S or whatever else.
Sorry, but the feature you request is not to be implemented now.

chipko, 2017-10-17:
I have used a uBEC with 5.25v out without issue but this isn't advisable :D

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

Closed 2017-10-17.

Thread 66 (2017-10-13):

Improvment: Link up to 3 receiver per arduino

elvince, 2017-10-13:
Hi,

First thanks for sharing this, it is really great.

Why didn't you link more receiver per Arduino? I think you can put up to 3 per arduino.
Was it because the loop will take more than 1ms?

If not, it might be an improvment that allow to have cheaper kit for 3 drones (which is great for friend racing!)

Thanks!

voroshkov, 2017-10-13:
Because of modular design.
Suggested improvement is out of scope of this project.

Closed 2017-10-13.

Thread 68 (2017-10-24):

Feature Requeste - Smart RSSI Detecting

ps915, 2017-10-24:
I always hate to calibrate the RSSI values before the race when you are two groups.

Why not measure the RSSI of each quad when they passes the first time the start/-finish gate like its done by the Delta5 Tracker?

voroshkov, 2017-10-24:
Can't imagine any reliable algorithm of measuring RSSI on-the-fly without any additional tools.
E.g. if for the first time you fly high above the gate should it be chosen as valid RSSI threshold? Or if you fly too close to the laptimer? How would it track further passes if you then fly higher (with lower RSSI)?

Thread 69 (2017-10-26):

Documentations

CorentinPacaud, 2017-10-26:
https://github.com/voroshkov/Chorus-RF-Laptimer/blob/1e01318f48f0c909f864a3713422c2f551f02a34/Arduino/chorus-rf-laptimer/rx5808spi.h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

Hi,
this is not an issue but a question about documentation.
In the code quoted (5lines), why did you do that ?
How did you know you have to do this transformation of data ?

Thx

voroshkov, 2017-10-27:
1. This code was contributed by @anunique.
2. There's an algorithm in rx5808 datasheet.

Closed 2017-10-27.

Thread 70 (2017-10-30):

TIMED RACE OPTION for rc buggies

ivkostic, 2017-10-30:
Hi! Great features so far! We tried it on the rc track for buggies, and is working superb! Only needed option for time limit for counting the laps/best lap. Can it be added 5 10 15 20 and 30 min of race, for counting the laps? This can be very usefull for rc car training

ivkostic, 2017-10-30:
ops i just saw an other topic with the similar header, this should be posted there.

voroshkov, 2017-10-30:
Wow! Are you using 5.8GHz VTx's just for laps tracking?

ivkostic, 2017-10-30:
yes  and it is perfect! we have a tons of ideas for buggy racing

ivkostic, 2017-10-30:
https://www.youtube.com/watch?v=KWu0FfP6fwM

lazar89nis, 2017-10-30:
Hi Andrey,

I wanted to show them how cool is you Android app for quadcopter racing and they took my device and started racing cars with it  :)

I can implement that part in iOS app but they only have android devices that is why i sent them to you :D

voroshkov, 2017-11-01:
Guys, sorry, but so far I don't have plans to extend the functionality of the Android app in this direction. Feel free to contribute and extend it.

voroshkov, 2018-04-27:
duplicate of #21

Closed 2018-04-27.

Thread 74 (2017-11-26):

Error while compiling

FPV-Rover, 2017-11-26:
I have to use Arduino 1.0.5 because it`s the only version which is running without problems on my GalliumOS, while compiling i always get the following error message:

#################################################################################
/usr/share/arduino/hardware/tools/avr/bin/avr-g++ -c -g -Os -Wall -fno-exceptions -ffunction-sections -fdata-sections -mmcu=atmega328p -DF_CPU=8000000L -MMD -DUSB_VID=null -DUSB_PID=null -DARDUINO=105 -D__PROG_TYPES_COMPAT__ -I/usr/share/arduino/hardware/arduino/cores/arduino -I/usr/share/arduino/hardware/arduino/variants/standard /tmp/build7368876175063967868.tmp/chorus_rf_laptimer.cpp -o /tmp/build7368876175063967868.tmp/chorus_rf_laptimer.cpp.o
In file included from chorus_rf_laptimer.ino:225:0:
sendSerialHex.h: In function ‘uint8_t send4BitsToSerial(uint8_t, uint8_t)’:
sendSerialHex.h:80:16: error: ‘class HardwareSerial’ has no member named ‘availableForWrite’
     if (Serial.availableForWrite() >= 5) { // e.g. "S1R1\n"
                ^
sendSerialHex.h: In function ‘uint8_t sendByteToSerial(uint8_t, uint8_t)’:
sendSerialHex.h:93:16: error: ‘class HardwareSerial’ has no member named ‘availableForWrite’
     if (Serial.availableForWrite() >= 6) {
                ^
sendSerialHex.h: In function ‘uint8_t sendIntToSerial(uint8_t, uint16_t)’:
sendSerialHex.h:106:16: error: ‘class HardwareSerial’ has no member named ‘availableForWrite’
     if (Serial.availableForWrite() >= 8) {
                ^
sendSerialHex.h: In function ‘uint8_t sendLongToSerial(uint8_t, uint32_t)’:
sendSerialHex.h:119:16: error: ‘class HardwareSerial’ has no member named ‘availableForWrite’
     if (Serial.availableForWrite() >= 12) {
                ^
sendSerialHex.h: In function ‘uint8_t sendLaptimeToSerial(uint8_t, uint8_t, uint32_t)’:
sendSerialHex.h:132:16: error: ‘class HardwareSerial’ has no member named ‘availableForWrite’
     if (Serial.availableForWrite() >= 14) {
                ^
chorus_rf_laptimer.ino: In function ‘void readSerialDataChunk()’:
chorus_rf_laptimer.ino:731:67: error: invalid conversion from ‘uint8_t* {aka unsigned char*}’ to ‘char*’ [-fpermissive]
In file included from /usr/share/arduino/hardware/arduino/cores/arduino/HardwareSerial.h:28:0,
                 from /usr/share/arduino/hardware/arduino/cores/arduino/Arduino.h:193,
                 from chorus_rf_laptimer.ino:51:
/usr/share/arduino/hardware/arduino/cores/arduino/Stream.h:76:10: note: initializing argument 1 of ‘size_t Stream::readBytes(char*, size_t)’
   size_t readBytes( char *buffer, size_t length); // read chars from stream into buffer
          ^
chorus_rf_laptimer.ino: In function ‘void sendProxyDataChunk()’:
chorus_rf_laptimer.ino:788:36: error: ‘class HardwareSerial’ has no member named ‘availableForWrite’
##################################################################################
Can someone help me fixing that ? or is there a workaround ? I goggled a lot but didnt found a working fix for that.

Thanks
Moe

voroshkov, 2017-12-01:
Moe, it looks like the versions of libraries you are using are outdated and don't support functions used in the "chorus_rf_laptimer.ino". You have to use more recent version of libraries (not sure if they are tied to Arduino IDE version)

FPV-Rover, 2017-12-02:
Appreciate for that info :+1: Spend 2 Hours to get the Arduino 1.8.5 to run and now i can compile :-) tomorow i will assemble it.
If somebody has the same issue:

The Problem was a missing Java runtime. I got the following failure message:

Picked up JAVA_TOOL_OPTIONS:
java.lang.Error: Cannot load com.sun.java.swing.plaf.gtk.GTKLookAndFeel
	at javax.swing.UIManager.initializeDefaultLAF(UIManager.java:1351)
	at javax.swing.UIManager.initialize(UIManager.java:1459)
	at javax.swing.UIManager.maybeInitialize(UIManager.java:1426)
	at javax.swing.UIManager.getLookAndFeel(UIManager.java:492)
	at processing.app.linux.GTKLookAndFeelFixer.installGtkPopupBugWorkaround(GTKLookAndFeelFixer.java:79)
	at processing.app.linux.Platform.setLookAndFeel(Platform.java:41)
	at processing.app.Base.<init>(Base.java:224)
	at processing.app.Base.main(Base.java:144)

It was simply just the missing java rte... but the v8 and 7 doesn`t support the Arduino IDE... so the solution was to install the icedtea-next rte (sudo apt-get install icedtea-next)

Now it runs like a charm.

Cheers
Moe

Closed 2017-12-02.

Thread 76 (2017-12-06):

[Request] Penalty button

JLOFPV, 2017-12-06:
It would be interesting to add a penalty button, so that if a driver jumps a door, can press and discount a specific time of that lap. Also, this time was configurable by each user. I attach example images.
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

jelly013, 2018-06-15:
Also maybe a option to delete a lap. Sometimes when I miss a gate I have to re-align and sometimes it triggers the timer. So I had a lap of 3 seconds

Thread 80 (2018-01-20):

PCB 4in1

Tomkanovik, 2018-01-20:
Does enyone have PCB 4in1 with efficient use of space? Please send me link for it.

ps915, 2018-02-16:
Like this?
https://www.youtube.com/watch?v=avLRJ5z0UP4

I am working on it. Hopefully released soon. Actually found one little think i must change on the PCB, rest is working

ps915, 2018-02-16:
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

Tomkanovik, 2018-02-17:
yes like this it is very nice :)

targetdozer, 2018-03-26:
What is the Status of the 4 in one? I will build up a Chorus for our Team. PCBs are new to me, so I would like to get some ready to order.
One question to your Layouts (8in1 and 4in1): Why do you mont the Receivers with the covered side up?
voroshkov writes:
Assembly of a Solo device
Correct positioning of RX5808 module against the finish gate area is vital for correct measurements.
I tried using different types of antennas and shields with RX5808 to achieve the best possible accuracy, and finally found that the module itself works as a short-range directional antenna.
# The non-shielded side of the module is a surface that should face the gate, so consider this fact upon assembling.

ps915, 2018-06-10:
Here you go:
https://github.com/ps915/Chorus-RF-Laptimer-PCB

ALopes90, 2018-09-25:
@ps915 the @targetdozer question is a very valid one, the "The non-shielded side of the module is supposed to face the gate?" I saw many people building one way and other building the other way, can't anyone test using it? I already order everything to build a 4 in 1 and I will make a 3D printable box to use with it and share it, but depending the way it needs to face the box with be different. Thanks

voroshkov, 2018-09-25:
I used both sides (practical use on our local events, which last from morning till evening). Both work fine.
I guess there may be differences, but someone needs to invent a method of testing to check which is more accurate ;)

ALopes90, 2018-09-25:
Ok Thanks, Good work

Thread 85 (2018-04-27):

Android app: pilots' names repeat after connecting to Chorus

voroshkov, 2018-04-27:
Description from a post in the Facebook Chorus group by StevenStudio Corp:

I built a Chorus with 6 nodes but I have a problem with the name of pilots, that is systematic when I my mobile android disconnects and reconnects to the Chorus. The pilots names 4, 5 and 6 become the same as pilots 1, 2 and 3.
When I use 4 nodes it is the same driver name that is repeated on all the nodes.
I use the latest version of Chorus Laptimer for android on a Huawei Honor 6 phone and a module DT06 wifi

Thread 86 (2018-04-27):

Android app relies on keeping all fragments in memory

voroshkov, 2018-04-27:
The app uses a "hack" to prevent unloading its screens from memory upon running setOffscreenPageLimit(4) (https://github.com/voroshkov/Chorus-RF-Laptimer/blob/1e01318f48f0c909f864a3713422c2f551f02a34/Android/ChorusRFLaptimer/app/src/main/java/app/andrey_voroshkov/chorus_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)

But this in unlikely the common practice in Android development.
Removing this line crashes the app when switching between screens.
I guess this needs to be fixed (remove setOffscreenPageLimit, and prevent app from crashing)

Thread 89 (2018-05-27):

The Chorus RF Laptimer v 0.75 application crashes when trying to reenter it

ammarraisafti, 2018-05-27:
# Expected behavior
After opening the Connect via Bluetooth feature, then switch to landscape display mode. the ability to switch to landscape view mode should be possible. And once the user exits the app. the ability to enter into the application too should be possible.

# Actual behavior
After unlocking the Connect via Bluetooth feature, then switching to landscape display mode, I redirected to the main page of the app. Next I minimize the app, then log back into the app, suddenly the application crashes and stops.

# How to reproduce
1. Install and open the app.

2. Click the top right shortcut, then select and open the Connect via Bluetooth feature.

3. Next you have to switch to landscape display mode, then you will find the problem as I have experienced. *Redirected to app main page.*

4. Next you have to minimize the application, then log back into the application. Then you will find the problem as I have experienced. *The application suddenly crashes and stops.*

* Browser: Samsung Galaxy S6 edge
* Operating system: Nougat 7.0
* App version: 0.7.5

# Recording Of The Bug
https://youtu.be/NFWPiGtgMm0

# Logcat
 <code> --------- beginning of crash
05-23 19:23:01.939 13357 13357 E AndroidRuntime: FATAL EXCEPTION: main
05-23 19:23:01.939 13357 13357 E AndroidRuntime: Process: app.andrey_voroshkov.chorus_laptimer, PID: 13357
05-23 19:23:01.939 13357 13357 E AndroidRuntime: java.lang.NullPointerException: Attempt to invoke virtual method 'int app.akexorcist.bluetotohspp.library.b.a()' on a null object reference
05-23 19:23:01.939 13357 13357 E AndroidRuntime: 	at app.akexorcist.bluetotohspp.library.a.b(Unknown Source)
05-23 19:23:01.939 13357 13357 E AndroidRuntime: 	at app.andrey_voroshkov.chorus_laptimer.c.a(Unknown Source)
05-23 19:23:01.939 13357 13357 E AndroidRuntime: 	at app.andrey_voroshkov.chorus_laptimer.b.a(Unknown Source)
05-23 19:23:01.939 13357 13357 E AndroidRuntime: 	at app.andrey_voroshkov.chorus_laptimer.p$2.onClick(Unknown Source)
05-23 19:23:01.939 13357 13357 E AndroidRuntime: 	at android.view.View.performClick(View.java:6205)
05-23 19:23:01.939 13357 13357 E AndroidRuntime: 	at android.widget.TextView.performClick(TextView.java:11103)
05-23 19:23:01.939 13357 13357 E AndroidRuntime: 	at android.widget.CompoundButton.performClick(CompoundButton.java:130)
05-23 19:23:01.939 13357 13357 E AndroidRuntime: 	at android.view.View$PerformClick.run(View.java:23653)
05-23 19:23:01.939 13357 13357 E AndroidRuntime: 	at android.os.Handler.handleCallback(Handler.java:751)
05-23 19:23:01.939 13357 13357 E AndroidRuntime: 	at android.os.Handler.dispatchMessage(Handler.java:95)
05-23 19:23:01.939 13357 13357 E AndroidRuntime: 	at android.os.Looper.loop(Looper.java:154)
05-23 19:23:01.939 13357 13357 E AndroidRuntime: 	at android.app.ActivityThread.main(ActivityThread.java:6682)
05-23 19:23:01.939 13357 13357 E AndroidRuntime: 	at java.lang.reflect.Method.invoke(Native Method)
05-23 19:23:01.939 13357 13357 E AndroidRuntime: 	at com.android.internal.os.ZygoteInit$MethodAndArgsCaller.run(ZygoteInit.java:1520)
05-23 19:23:01.939 13357 13357 E AndroidRuntime: 	at com.android.internal.os.ZygoteInit.main(ZygoteInit.java:1410)
05-23 19:23:01.961  3702  4517 D Debug   : !@DumpState : SHIP
05-23 19:23:01.961  3702  4517 D Debug   : !@DumpState : debug level:0x4f4c
05-23 19:23:01.961  3702  4517 D Debug   : !@Dumpstate : Finally, system will skip dumpstate
05-23 19:23:01.966  3702  4517 W ActivityManager:   Force finishing activity </code>

Thread 91 (2018-05-29):

Chorus RF Laptimer v 0.7.6 Crash when clicking the plus icon (+) in android 7.0

ammarraisafti, 2018-05-29:
# Expected behavior
After disabling the Speak Messages feature and the Speak Lap Times feature, then minimize the app.It should be when I re-enter to the app, the Speak Messages feature and the Speak Lap Times feature are no longer active by itself.And when I turn those two features off again, then click the plus icon (+), to add Time to Prepare for Race.The ability to add Time to Prepare for Race should be possible.

# Actual behavior
After disabling the Speak Messages feature and the Speak Lap Times feature, I minimize the app. And when I reentered the app, l look the Speak Messages feature and the Speak Lap Times feature have been enabled by itself. And I deactivate again both features, then click the plus (+) icon to add Time to Prepare for Race.Suddenly the application crashes and stops.

# How to reproduce
* Launch app.
* Disable the Speak Messages feature and Speak Lap Times feature.
* Minimize apps.
* Log back into the app.
* *Both features that have been disabled, have been reactivated.*
* Disable both features again.
* Then click the plus icon (+) in the section Times to Prepare for Race menu.
* Then you will find the problem as I have explained.
* *The application crashes and suddenly stops.*

<center>Browser: Samsung Galaxy S6 edge
Operating system: Nougat 7.0
App version: 0.7.6 </center>

# Recording Of The Bug
https://youtu.be/8SlY2Lp3D-w

# Logcat
<code>--------- beginning of crash
05-29 14:56:15.376 16612 16612 E AndroidRuntime: FATAL EXCEPTION: main
05-29 14:56:15.376 16612 16612 E AndroidRuntime: Process: app.andrey_voroshkov.chorus_laptimer, PID: 16612
05-29 14:56:15.376 16612 16612 E AndroidRuntime: java.lang.RuntimeException: Unable to start activity ComponentInfo{app.andrey_voroshkov.chorus_laptimer/app.andrey_voroshkov.chorus_laptimer.MainActivity}: java.lang.IllegalStateException: Fragment p{567db36} not attached to Activity
05-29 14:56:15.376 16612 16612 E AndroidRuntime: 	at android.app.ActivityThread.performLaunchActivity(ActivityThread.java:2927)
05-29 14:56:15.376 16612 16612 E AndroidRuntime: 	at android.app.ActivityThread.handleLaunchActivity(ActivityThread.java:2988)
05-29 14:56:15.376 16612 16612 E AndroidRuntime: 	at android.app.ActivityThread.-wrap14(ActivityThread.java)
05-29 14:56:15.376 16612 16612 E AndroidRuntime: 	at android.app.ActivityThread$H.handleMessage(ActivityThread.java:1631)
05-29 14:56:15.376 16612 16612 E AndroidRuntime: 	at android.os.Handler.dispatchMessage(Handler.java:102)
05-29 14:56:15.376 16612 16612 E AndroidRuntime: 	at android.os.Looper.loop(Looper.java:154)
05-29 14:56:15.376 16612 16612 E AndroidRuntime: 	at android.app.ActivityThread.main(ActivityThread.java:6682)
05-29 14:56:15.376 16612 16612 E AndroidRuntime: 	at java.lang.reflect.Method.invoke(Native Method)
05-29 14:56:15.376 16612 16612 E AndroidRuntime: 	at com.android.internal.os.ZygoteInit$MethodAndArgsCaller.run(ZygoteInit.java:1520)
05-29 14:56:15.376 16612 16612 E AndroidRuntime: 	at com.android.internal.os.ZygoteInit.main(ZygoteInit.java:1410)
05-29 14:56:15.376 16612 16612 E AndroidRuntime: Caused by: java.lang.IllegalStateException: Fragment p{567db36} not attached to Activity
05-29 14:56:15.376 16612 16612 E AndroidRuntime: 	at android.support.v4.b.l.d(Unknown Source)
05-29 14:56:15.376 16612 16612 E AndroidRuntime: 	at android.support.v4.b.l.a(Unknown Source)
05-29 14:56:15.376 16612 16612 E AndroidRuntime: 	at app.andrey_voroshkov.chorus_laptimer.p.c(Unknown Source)
05-29 14:56:15.376 16612 16612 E AndroidRuntime: 	at app.andrey_voroshkov.chorus_laptimer.p.a(Unknown Source)
05-29 14:56:15.376 16612 16612 E AndroidRuntime: 	at app.andrey_voroshkov.chorus_laptimer.p$1.a(Unknown Source)
05-29 14:56:15.376 16612 16612 E AndroidRuntime: 	at app.andrey_voroshkov.chorus_laptimer.b.a(Unknown Source)
05-29 14:56:15.376 16612 16612 E AndroidRuntime: 	at app.andrey_voroshkov.chorus_laptimer.b.v(Unknown Source)
05-29 14:56:15.376 16612 16612 E AndroidRuntime: 	at app.andrey_voroshkov.chorus_laptimer.a.b(Unknown Source)
05-29 14:56:15.376 16612 16612 E AndroidRuntime: 	at app.andrey_voroshkov.chorus_laptimer.a.d(Unknown Source)
05-29 14:56:15.376 16612 16612 E AndroidRuntime: 	at app.andrey_voroshkov.chorus_laptimer.MainActivity.onCreate(Unknown Source)
05-29 14:56:15.376 16612 16612 E AndroidRuntime: 	at android.app.Activity.performCreate(Activity.java:6942)
05-29 14:56:15.376 16612 16612 E AndroidRuntime: 	at android.app.Instrumentation.callActivityOnCreate(Instrumentation.java:1126)
05-29 14:56:15.376 16612 16612 E AndroidRuntime: 	at android.app.ActivityThread.performLaunchActivity(ActivityThread.java:2880)
05-29 14:56:15.376 16612 16612 E AndroidRuntime: 	... 9 more
05-29 14:58:55.392 16791 16791 E AndroidRuntime: FATAL EXCEPTION: main
05-29 14:58:55.392 16791 16791 E AndroidRuntime: Process: app.andrey_voroshkov.chorus_laptimer, PID: 16791
05-29 14:58:55.392 16791 16791 E AndroidRuntime: java.lang.IllegalStateException: Fragment p{cbb09b9} not attached to Activity
05-29 14:58:55.392 16791 16791 E AndroidRuntime: 	at android.support.v4.b.l.d(Unknown Source)
05-29 14:58:55.392 16791 16791 E AndroidRuntime: 	at android.support.v4.b.l.a(Unknown Source)
05-29 14:58:55.392 16791 16791 E AndroidRuntime: 	at app.andrey_voroshkov.chorus_laptimer.p.c(Unknown Source)
05-29 14:58:55.392 16791 16791 E AndroidRuntime: 	at app.andrey_voroshkov.chorus_laptimer.p.a(Unknown Source)
05-29 14:58:55.392 16791 16791 E AndroidRuntime: 	at app.andrey_voroshkov.chorus_laptimer.p$1.a(Unknown Source)
05-29 14:58:55.392 16791 16791 E AndroidRuntime: 	at app.andrey_voroshkov.chorus_laptimer.b.a(Unknown Source)
05-29 14:58:55.392 16791 16791 E AndroidRuntime: 	at app.andrey_voroshkov.chorus_laptimer.b.v(Unknown Source)
05-29 14:58:55.392 16791 16791 E AndroidRuntime: 	at app.andrey_voroshkov.chorus_laptimer.p$20.onClick(Unknown Source)
05-29 14:58:55.392 16791 16791 E AndroidRuntime: 	at android.view.View.performClick(View.java:6205)
05-29 14:58:55.392 16791 16791 E AndroidRuntime: 	at android.widget.TextView.performClick(TextView.java:11103)
05-29 14:58:55.392 16791 16791 E AndroidRuntime: 	at android.view.View$PerformClick.run(View.java:23653)
05-29 14:58:55.392 16791 16791 E AndroidRuntime: 	at android.os.Handler.handleCallback(Handler.java:751)
05-29 14:58:55.392 16791 16791 E AndroidRuntime: 	at android.os.Handler.dispatchMessage(Handler.java:95)
05-29 14:58:55.392 16791 16791 E AndroidRuntime: 	at android.os.Looper.loop(Looper.java:154)
05-29 14:58:55.392 16791 16791 E AndroidRuntime: 	at android.app.ActivityThread.main(ActivityThread.java:6682)
05-29 14:58:55.392 16791 16791 E AndroidRuntime: 	at java.lang.reflect.Method.invoke(Native Method)
05-29 14:58:55.392 16791 16791 E AndroidRuntime: 	at com.android.internal.os.ZygoteInit$MethodAndArgsCaller.run(ZygoteInit.java:1520)
05-29 14:58:55.392 16791 16791 E AndroidRuntime: 	at com.android.internal.os.ZygoteInit.main(ZygoteInit.java:1410)
05-29 14:59:06.212 18009 18009 E AndroidRuntime: FATAL EXCEPTION: main
05-29 14:59:06.212 18009 18009 E AndroidRuntime: Process: app.andrey_voroshkov.chorus_laptimer, PID: 18009
05-29 14:59:06.212 18009 18009 E AndroidRuntime: java.lang.RuntimeException: Unable to start activity ComponentInfo{app.andrey_voroshkov.chorus_laptimer/app.andrey_voroshkov.chorus_laptimer.MainActivity}: java.lang.IllegalStateException: Fragment p{5118798} not attached to Activity
05-29 14:59:06.212 18009 18009 E AndroidRuntime: 	at android.app.ActivityThread.performLaunchActivity(ActivityThread.java:2927)
05-29 14:59:06.212 18009 18009 E AndroidRuntime: 	at android.app.ActivityThread.handleLaunchActivity(ActivityThread.java:2988)
05-29 14:59:06.212 18009 18009 E AndroidRuntime: 	at android.app.ActivityThread.-wrap14(ActivityThread.java)
05-29 14:59:06.212 18009 18009 E AndroidRuntime: 	at android.app.ActivityThread$H.handleMessage(ActivityThread.java:1631)
05-29 14:59:06.212 18009 18009 E AndroidRuntime: 	at android.os.Handler.dispatchMessage(Handler.java:102)
05-29 14:59:06.212 18009 18009 E AndroidRuntime: 	at android.os.Looper.loop(Looper.java:154)
05-29 14:59:06.212 18009 18009 E AndroidRuntime: 	at android.app.ActivityThread.main(ActivityThread.java:6682)
05-29 14:59:06.212 18009 18009 E AndroidRuntime: 	at java.lang.reflect.Method.invoke(Native Method)
05-29 14:59:06.212 18009 18009 E AndroidRuntime: 	at com.android.internal.os.ZygoteInit$MethodAndArgsCaller.run(ZygoteInit.java:1520)
05-29 14:59:06.212 18009 18009 E AndroidRuntime: 	at com.android.internal.os.ZygoteInit.main(ZygoteInit.java:1410)
05-29 14:59:06.212 18009 18009 E AndroidRuntime: Caused by: java.lang.IllegalStateException: Fragment p{5118798} not attached to Activity
05-29 14:59:06.212 18009 18009 E AndroidRuntime: 	at android.support.v4.b.l.d(Unknown Source)
05-29 14:59:06.212 18009 18009 E AndroidRuntime: 	at android.support.v4.b.l.a(Unknown Source)
05-29 14:59:06.212 18009 18009 E AndroidRuntime: 	at app.andrey_voroshkov.chorus_laptimer.p.c(Unknown Source)
05-29 14:59:06.212 18009 18009 E AndroidRuntime: 	at app.andrey_voroshkov.chorus_laptimer.p.a(Unknown Source)
05-29 14:59:06.212 18009 18009 E AndroidRuntime: 	at app.andrey_voroshkov.chorus_laptimer.p$1.a(Unknown Source)
05-29 14:59:06.212 18009 18009 E AndroidRuntime: 	at app.andrey_voroshkov.chorus_laptimer.b.a(Unknown Source)
05-29 14:59:06.212 18009 18009 E AndroidRuntime: 	at app.andrey_voroshkov.chorus_laptimer.b.v(Unknown Source)
05-29 14:59:06.212 18009 18009 E AndroidRuntime: 	at app.andrey_voroshkov.chorus_laptimer.a.b(Unknown Source)
05-29 14:59:06.212 18009 18009 E AndroidRuntime: 	at app.andrey_voroshkov.chorus_laptimer.a.d(Unknown Source)
05-29 14:59:06.212 18009 18009 E AndroidRuntime: 	at app.andrey_voroshkov.chorus_laptimer.MainActivity.onCreate(Unknown Source)
05-29 14:59:06.212 18009 18009 E AndroidRuntime: 	at android.app.Activity.performCreate(Activity.java:6942)
05-29 14:59:06.212 18009 18009 E AndroidRuntime: 	at android.app.Instrumentation.callActivityOnCreate(Instrumentation.java:1126)
05-29 14:59:06.212 18009 18009 E AndroidRuntime: 	at android.app.ActivityThread.performLaunchActivity(ActivityThread.java:2880)
05-29 14:59:06.212 18009 18009 E AndroidRuntime: 	... 9 more
05-29 14:59:12.505 18128 18128 E AndroidRuntime: FATAL EXCEPTION: main
05-29 14:59:12.505 18128 18128 E AndroidRuntime: Process: app.andrey_voroshkov.chorus_laptimer, PID: 18128
05-29 14:59:12.505 18128 18128 E AndroidRuntime: java.lang.RuntimeException: Unable to start activity ComponentInfo{app.andrey_voroshkov.chorus_laptimer/app.andrey_voroshkov.chorus_laptimer.MainActivity}: java.lang.IllegalStateException: Fragment p{1ce23d6} not attached to Activity
05-29 14:59:12.505 18128 18128 E AndroidRuntime: 	at android.app.ActivityThread.performLaunchActivity(ActivityThread.java:2927)
05-29 14:59:12.505 18128 18128 E AndroidRuntime: 	at android.app.ActivityThread.handleLaunchActivity(ActivityThread.java:2988)
05-29 14:59:12.505 18128 18128 E AndroidRuntime: 	at android.app.ActivityThread.-wrap14(ActivityThread.java)
05-29 14:59:12.505 18128 18128 E AndroidRuntime: 	at android.app.ActivityThread$H.handleMessage(ActivityThread.java:1631)
05-29 14:59:12.505 18128 18128 E AndroidRuntime: 	at android.os.Handler.dispatchMessage(Handler.java:102)
05-29 14:59:12.505 18128 18128 E AndroidRuntime: 	at android.os.Looper.loop(Looper.java:154)
05-29 14:59:12.505 18128 18128 E AndroidRuntime: 	at android.app.ActivityThread.main(ActivityThread.java:6682)
05-29 14:59:12.505 18128 18128 E AndroidRuntime: 	at java.lang.reflect.Method.invoke(Native Method)
05-29 14:59:12.505 18128 18128 E AndroidRuntime: 	at com.android.internal.os.ZygoteInit$MethodAndArgsCaller.run(ZygoteInit.java:1520)
05-29 14:59:12.505 18128 18128 E AndroidRuntime: 	at com.android.internal.os.ZygoteInit.main(ZygoteInit.java:1410)
05-29 14:59:12.505 18128 18128 E AndroidRuntime: Caused by: java.lang.IllegalStateException: Fragment p{1ce23d6} not attached to Activity
05-29 14:59:12.505 18128 18128 E AndroidRuntime: 	at android.support.v4.b.l.d(Unknown Source)
05-29 14:59:12.505 18128 18128 E AndroidRuntime: 	at android.support.v4.b.l.a(Unknown Source)
05-29 14:59:12.505 18128 18128 E AndroidRuntime: 	at app.andrey_voroshkov.chorus_laptimer.p.c(Unknown Source)
05-29 14:59:12.505 18128 18128 E AndroidRuntime: 	at app.andrey_voroshkov.chorus_laptimer.p.a(Unknown Source)
05-29 14:59:12.505 18128 18128 E AndroidRuntime: 	at app.andrey_voroshkov.chorus_laptimer.p$1.a(Unknown Source)
05-29 14:59:12.505 18128 18128 E AndroidRuntime: 	at app.andrey_voroshkov.chorus_laptimer.b.a(Unknown Source)
05-29 14:59:12.505 18128 18128 E AndroidRuntime: 	at app.andrey_voroshkov.chorus_laptimer.b.v(Unknown Source)
05-29 14:59:12.505 18128 18128 E AndroidRuntime: 	at app.andrey_voroshkov.chorus_laptimer.a.b(Unknown Source)
05-29 14:59:12.505 18128 18128 E AndroidRuntime: 	at app.andrey_voroshkov.chorus_laptimer.a.d(Unknown Source)
05-29 14:59:12.505 18128 18128 E AndroidRuntime: 	at app.andrey_voroshkov.chorus_laptimer.MainActivity.onCreate(Unknown Source)
05-29 14:59:12.505 18128 18128 E AndroidRuntime: 	at android.app.Activity.performCreate(Activity.java:6942)
05-29 14:59:12.505 18128 18128 E AndroidRuntime: 	at android.app.Instrumentation.callActivityOnCreate(Instrumentation.java:1126)
05-29 14:59:12.505 18128 18128 E AndroidRuntime: 	at android.app.ActivityThread.performLaunchActivity(ActivityThread.java:2880)
05-29 14:59:12.505 18128 18128 E AndroidRuntime: 	... 9 more</code>

Thread 93 (2018-05-31):

come back from connect via Bluetooth page for screen rotation

somrat420, 2018-05-31:
Expected behavior
it should be stay on the Bluetooth page while screen rotation

Actual behavior
in Bluetooth page it comes back for screen rotation from portrait to landscape .

How to reproduce
* download the app
* open it and click on connect via Bluetooth
* then rotated your phone from portrait to landscape
* note the bug

https://m.youtube.com/watch?v=7-FKICSwnpY

gpolic, 2018-06-28:
I think that there are generally some issues with the Lifecycle and the layouts

To @voroshkov
Regarding the Bluetooth starting and stopping.
Try to experiment and move it to onStart and onStop (you need to override these methods)
Remove code from onDestroy. The application maybe in memory for hours before the onDestroy is called to clean up memory.

Regarding the layout.
If the layout is not loaded correctly, then the viewPager maybe null
Check for null first, before doing any actions on it on MainActivity.
(can your viewPager be invisible during a rotation to Landscape ?)

Having said that... I do not have the hardware, so I cannot run or do any tests

voroshkov, 2018-06-28:
@gpolic, thanks a lot!!!
Can you elaborate a bit?
- onStart/onStop/onDestroy - do you mean main activity methods?
- where should I put the code from onDestroy?
- rotation to landscape is not possible
- why layout may be not loaded correctly?

gpolic, 2018-06-29:
Right, I mean the MainActivity methods
Try to connect Bluetooth on onStart and disconnect it on onStop
The code from onDestroy can go to OnStop
onStart is already there. You can move the initBluetooth that setup the listeners to onStart also.
This is just a test to check the behavior, in terms of Lifecycle

I have checked your manifest and it looks like orientation is locked.
However the Activity DeviceList on the BlueTooth library can be rotated.
I think this is why the user mentions rotation from portrait to landscape
A quick fix, may be, to lock this activity on Portrait orientation. I would try that first, before anything else.

Try to check if viewPager is null, right after this line in onCreate/MainActivity:
mViewPager = (ViewPager) findViewById(R.id.container);

if it is not null, then use it.
If it is null then do something else finish() or Log it, to view it on your logs.

Also on this line in onCreate/MainActivity:
SectionsPagerAdapter mSectionsPagerAdapter = new SectionsPagerAdapter(getSupportFragmentManager(), getResources());

Most of the examples of PagerAdapter I have read are using the constructor without resources. Just the FragmentManager. I am suprised you have getResources.
Try to use the constructor with out getResources.

If the app has been put to the background and then started again, this getResources maybe pointing to a null object or something else.

I am just putting out ideas and trying to help
As said i dont have the hardware so I cannot test anything.

voroshkov, 2018-06-29:
Great! Thanks for valuable input. Will try that stuff!
As for moving BT disconnection to onStop - I tried that yesterday and as a result it stopped connecting after first disconnection. Had not much time to investigate why, so just left that as is.

gpolic, 2018-06-29:
ok sure !  maybe forget about that onStart & onStop stuff.

Another thing for the MainActivity:

    public void onActivityResult(int requestCode, int resultCode, Intent data) {
if (requestCode == BluetoothState.REQUEST_CONNECT_DEVICE) {
e.t.c.

You can insert `super.onActivityResult(requestCode, resultCode, data); ` as the first line of code in this method. Maybe it has to do some clean up when the Activity returns (for example DeviceList activity)

Thread 97 (2018-09-19):

Temperature Problem

ALopes90, 2018-09-19:
Hi mates, here in Portugal we have a long Summer with high temperatures so many times we have problems with the receivers over heating, I know nothing about arduino, so I ask to you, it would be very difficult to implement a temperature sensor with a fan control  like what this does?

https://www.aliexpress.com/item/WS16-DC-12V-4A-PWM-PC-CPU-Fan-Temperature-Control-Regulator-Thermostat-Speed-Controller-Switch-High/32818888635.html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,searchweb201602_4_10065_10068_10059_10884_10887_10696_100031_10084_10083_10103_10618_10304_10307_10820_10821_10301,searchweb201603_1,ppcSwitch_2&algo_expid=9b463102-5c70-4326-b069-227134ca6145-3&algo_pvid=9b463102-5c70-4326-b069-227134ca6145&transAbTest=ae803_2&priceBeautifyAB=0

Thanks for all your work, this is just one ideia that I think will help many people, I'm going to make a box for the 4in1 project to use a fan and a controller like the one in the link.

voroshkov, 2018-09-24:
Hi @ALopes90. I think that the fan control is a kind of excess. Instead you may just run your fan at full speed and have no worries about implementing/tuning the fan control.

ALopes90, 2018-09-24:
Thanks, I can't help in that part, I don't know how.
Keep up the great work you all are doing.

Thread 98 (2018-12-16):

Would it be possible to use Esp32 or ESP8266 as the main MCU?

JesusGonfer, 2018-12-16:
It would be possible to use one of these devices to replace the arduino. With this we would get wifi / bluetooth in a simpler way

voroshkov, 2018-12-17:
There's a project with ESP32 already. Check recent posts in the Facebook group.

JesusGonfer, 2018-12-17:
thank you very much I can help you in that!

Closed 2018-12-17.

Thread 100 (2019-02-24):

[Feature Request] Serial Enhancement more API Messages (Race End, Pilot finished, target laps... etc.))

El-Tonno, 2019-02-24:
Hi,

i added an esp8266 which is watching the serial output on the Chorus and publish the messages into a Wifi-Mesh. So other devices such as traffic lights, LEDs etc. in the mesh can react independently on the serial output .

Unfortunately some messages are missing. Would be nice if the serial output could be enhanced by the following states:
- amount of Laps have to be done ( at race start.. before R*R1 for e.g.)
- information pilot has finished the last lap (after S0L5XXXXXX)
- race finished (all pilots have finished the last lap)
- direct feedback if the amount of laps is changed in the app (like the feedback ignore 1st lap R*11/R*10)

Thanks a lot
Greets el-tonno

voroshkov, 2019-02-25:
Hi,

Unfortunately these are not the things to be managed by Chorus device itself.
These parameters are expected to be managed by the race control software, so you need to integrate with the latter to monitor the information you want.
Chorus API just forwards the unknown commands through the chain, so any command not recognized by  Chorus will be forwarded to your ESP.

El-Tonno, 2019-02-25:
I see ... ok this was my little missunderstanding of the Chorus and the Chorus App architecture. I confess i`m not very good in apk developement.
Now i had a look at the app src and i think RaceResultFragment.java would be right place.

Line 46 : AppState.getInstance().sendBtCommand("R*R1");

Could you please add just one line ?

something like that-->
  AppState.getInstance().sendBtCommand("LTG*" + String.format("%01X", LAPS_TO_GO) );

With the amount of laps i would be able to calculate the rest of the messages i mentoined above.

Thank you very much
el-tonno

El-Tonno, 2019-03-02:
Hi again ... i please you to help me :-)
Don´t wanna recompile your app and building a derivate. This little additiononal message won´t hurt anybody ... and could be usefull in other projects.
Please just implement this in your next version of the app.
What do you think ?

voroshkov, 2019-03-05:
Hi. Generally it's ok to do. But I'm out of time at the moment. Need about a week to return to this.

El-Tonno, 2019-03-15:
Hi Thanks a lot ...would be nice if this is available in the next Version.

Meanwhile i made the changes myself ...

I added follwing line  47 at RaceResultFragment
AppState.getInstance().sendBtCommand("LTG*" + String.format("%01X", RaceState.lapsToGo));

and made the the lapsToGo static for access
public static int lapsToGo;

So no hurry :-)

Thread 101 (2019-03-17):

The problem with the application iOS.

Kostya989, 2019-03-17:
I did not find how to contact the author of the application.
There are problems connecting via Wi-Fi. The connection is unstable, it seems that the smartphone is falling asleep and the connection is broken.
And in case of a successful connection, a message appears.
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
Tested on
iPhone 7 iOS 12.1.4
iPad 10.5 iOS 12.1.4

voroshkov, 2019-03-18:
Please check in the Facebook group. If I remember correctly Lazar Djordjevic mentioned that new version of iOS app is going to be released soon. Meanwhile you may change the API Version in Arduino code to 4 to have your app working

Kostya989, 2019-03-18:
Ok, thanks. I will try to figure out where to change the API.

Closed 2019-07-03.

Thread 111 (2020-01-02):

Debug RX5808?

SidneyBovet, 2020-01-02:
Hi, I just got my feet wet by building a Solo device using Bluetooth. I could set the baud rate on the module, and the Android app connects successfully, but there seem to be an issue with the RX5808 module.

The RSSI value reported by the app seems to move up slowly as the radio module heats up (value moves within the 80 - 90 range). When I manually disconnect the RSSI pin (A3 on the Arduino) I see that value changing, so I am assuming everything works correctly on the Arduino  side.

The module I got it [this one](https://www.aliexpress.com/item/32879068001.html?spm=a2g0s.9042311.0.0.27424c4djpRaVK). It looks like it is already working in SPI mode, but just to be sure I opened the lid and checked, the SPI_EN pin on the MCU is missing an SMD resistor. So it seems that it indeed is SPI ready.

Now, when I probe the SPI_CLK pin (CH3 on the PCB) I don't see a clock signal. Is it because the clock signal is only there when the board tries to communicate with the radio module? More generally, how would you go about debugging this?

SidneyBovet, 2020-01-02:
I got it working. I don't know how but I did. What may have solved it all is I was playing with the Android interface, and I unticked the channel right above the pilot name on the Pilots tab. When I ticked it back on, I got a sensible RSSI reading that corresponded to how I moved with my drone.

Anyhow, I guess the question of how to debug such a situation still holds, but this issue may be closed!

StarrrLiteNL, 2020-01-07:
Just to chime in: I have the same "issue" with the Android app; Whenever first connecting, I have to disable all channels and enable them 1 by 1 to get them to reliably work.

I think this stems from the fact that the communication between the app and the chorus is via UDP, which has no guaranteed delivery or acknowledgement state.

This means that the app sends a "enable this channel on this frequency" message, but it has no way of checking wether the chorus device actually received the message. Thats just a downside of using UDP instead of TCP (upside is speed, less overhead and simpler to program/manage).

The same issue can arise when switching channels or changing RSSI thresholds. It sometimes misses a message/command, especially if you are at the edge of your Bluetooth/WiFi range.

The best way to solve these issues would be to switch to switch the app and firmware to TCP/IP and/or have an acknowledgement for each sent command to the tracker, with the ability for the app to resend lost commands etc.

Perhaps worth it to open a new ticket to improve this, since it can be quite annoying and would improve (perceived) reliability .

Thread 112 (2020-01-06):

Connecting to chorus over WiFi attempts to connect to 0.0.0.0

StarrrLiteNL, 2020-01-06:
Whenever I try to connect to my chorus with my phone over WiFi, I get the message "connected to 0.0.0.0" and I get the "disconnected" message immediately after that.

I am connected to the correct WiFi network, and I can reach the gateway up (192.168.4.1). All WiFi module settings are correct.

It has worked before on this phone and I can connect without issues from my Nexus 7 tablet.

I suspect the recent software update to Android 10 on my phone broke it.

It always used to be a bit finicky to connect, I always had to connect then wait for the "stay connected anyway" message to come and confirm. After confirmation it would work fine. I can't get that confirmation message to appear anymore tho (I have not seen it ever since the update) perhaps they removed it in Android 10 or the latest OxygenOS?

I have tried turning off mobile data and Bluetooth, but both didn't solve the issue.

Switching the WiFi module to a Bluetooth module does allow me to use the chorus fine, but the WiFi module has a much better range so I would love to use that instead.

Specs:
Phone; (can't connect via WiFi)
Oneplus 6
Android 10
OxygenOS 10.3.0

Tablet; (can connect via WiFi)
Nexus 7 (2013 version)
Android 8
AOSP custom ROM

realhuno, 2020-02-24:
Hi, i have the same issue.  Nobody Can help us??
Huawei P30 Pro. Not working...
Old Sony Phone working...

voroshkov, 2020-02-25:
It looks like the problem is with Android 10 devices only. I don't have such a device to debug so far.

marcfon, 2020-04-29:
Exactly the same issue here.

Thread 116 (2020-09-02):

SET function missing in android app

TwoToneEddy, 2020-09-02:
Hi,
It looks like the SET button for the automatic setting of the RSSI is missing, does anyone know why? This is on the android app.
Thanks

Thread 118 (2022-01-10):

[Feature Request] Connect to something other than the default gateway

CapnBry, 2022-01-10:
When connecting with the Chorus Android app over wifi it always connects to the default gateway IP, assuming the wifi AP is the Chorus device. However, with Chorus32 in client mode, it can be any IP address. When whooping at home, the range of the ESP32's wifi is spotty back to my phone so the connection tends to drop off and go back to the other wifi network, which breaks the lap timer.

I think ideally it should do an mDNS query to find the lap timer on the network, but a good substitute would be to just let the user enter the IP or hostname of the timer device. I believe the hostname "chorus32" would just work for both AP and STA mode.
