voroshkov/Chorus-RF-Laptimer/(list of files, drawings)

Other design files:
DipTrace/ChorusLaptimer.dch
DipTrace/ChorusLaptimer.dip
