voroshkov/Chorus-RF-Laptimer/(commit log)

2017-03-19 add rcgroups thread link
2017-03-24 fix #12 (no RSSI displayed for last device)
2017-04-05 update schematic
2017-04-07 keep preferences for detached Solo devices
2017-04-10 close #7 (battery monitoring & low voltage alarm)
2017-04-11 add schematic & PCB; update version
    [ChorusLaptimer.dch, ChorusLaptimer.dip]
2017-04-11 update wiring for LiPo voltage monitoring
2017-05-04 add feature to adjust monitored LiPo voltage
2017-05-04 update README.md with LiPo monitoring docs
2017-06-19 Fix build issue on case sensitive file system
2017-06-22 speak "race finished" after confirmation arrives from device
2017-07-04 fix #22 (inability to setup nodes higher than 4)
    [PilotsRssiListAdapter.java]
2017-07-16 set rssithreshold, set frequency
    first commit was a fail so heres another try:
    you cant set rssithreshold now
    you can set any frequency now
    [channels.h, rx5808spi.h, sendSerialHex.h]
2017-07-26 update wiring and readme
2017-07-28 return lipo monitor resistor divider onto diagram
2017-09-05 add PCB by Joao Reis
2017-09-11 fix channel selection glitches during occuring interrupts
    [rx5808spi.h]
2017-09-18 update API xlsx
    [ChorusAPI.xlsx]
2017-10-08 fix some i18n issues
    [PilotsRssiListAdapter.java]
2017-10-25 update with new commands
    [ChorusAPI.xlsx]
2017-10-27 rename .ino and folder to open in Arduino IDE in Linux
2017-11-03 modifications for rx5808spi driver
2018-05-07 update threshold setting algorithm: use slowRssi for peaks, revise constants to make more error-proof
    [chorus_rf_laptimer.ino, pinAssignments.h]
2018-05-22 reworks the API command set
    [channels.h, chorus_rf_laptimer.ino, sounds.h]
2018-05-23 update API doc with v4 commands
    [ChorusAPI.xlsx]
2018-07-01 add some checks to prevent exceptions, prevent rotation of BT devices view
2018-07-16 fix UDP connection code to kill unnecessary threads; fix connection menu; minor changes;
2018-07-27 use software filtering of RSSI by default
2018-09-24 add voltage conversion formula
    [ChorusAPI.xlsx]
2018-12-31 use better rssi filtering, add experimental lap tracking, update API
2018-12-31 add random start, add "experimental feature" switch
2018-12-31 update API docs
    [ChorusAPI.xlsx]
2019-01-07 fix detection algorithm (don't use PROGMEM because it requires special reading commands)
    [chorus_rf_laptimer.ino, lapDetectionRoutines.h, mainDetectionAlgorithm.h, sounds.h]
2019-02-09 fix issue with re-enabling a disabled node after scrolling back and forth attempt to fix issue with inability to send commands after connection
    [PilotsRssiListAdapter.java]
2019-06-26 Implement Arduino power down code.
2019-07-04 Fix wrong register when powering down features
    [rx5808spi.h]
2019-07-04 Fix resetModule and powerDownModule to compile with the newest changes
    [rx5808spi.h]
2019-07-04 update support for power-down mode in android app; update API version and docs
    [ChorusAPI.xlsx]
